mob5824m-wq/OpenTag/docs/app-ui-preview.png

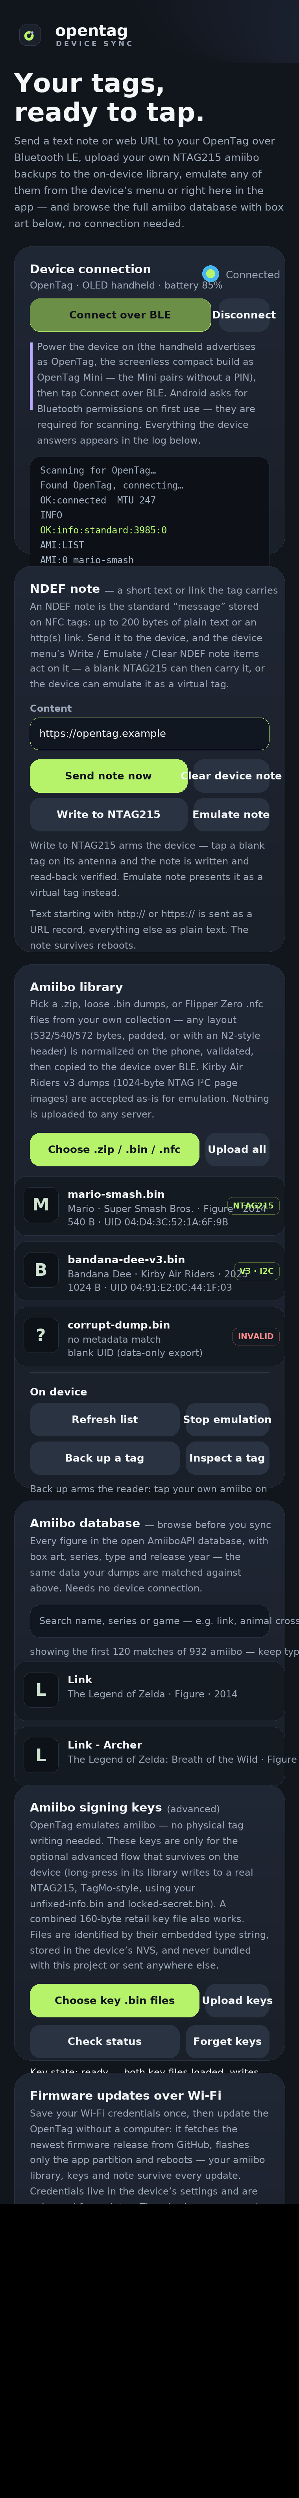
docs/app-ui-preview.png
