mob5824m-wq/OpenTag/docs/stand-engravings.png

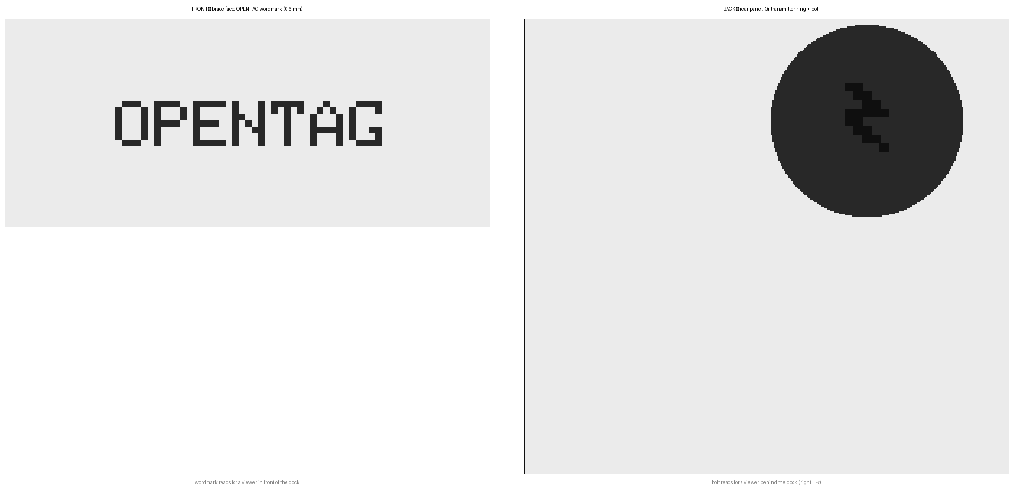
docs/stand-engravings.png
