mob5824m-wq/OpenTag/docs/BOM.md

# OpenTag parts list (BOM)

## Core electronics

| # | Part | Qty | Notes |
|---|---|----|---|
| 1 | ESP32-S3-DevKitC-1 (N8R2 or N16R8, 16 MB flash recommended) | 1 | The 16 MB layout assumed by `partitions_16mb.csv`; an 8 MB board works after switching to a smaller partition table |
| 2 | PN532Killer (NFC-funs, ST25R3916) | 1 | Replaces a PN532 entirely: presents a real 7-byte UID, 8 emulator slots; get the UART-firmware version |
| 3 | SSD1351 1.3" 128×128 OLED module, SPI, 7-pin | 1 | 3.3 V, GH1313-style header |
| 4 | LiPo cell 805040 (3.7 V, ~800 mAh, with protection + JST-PH lead) | 1 | Any 3.7 V cell that fits the shell bay; adjust `bat_*` in the `.cad` |
| 5 | TP4056 USB-C charging module **with protection** (DW01A + 8205A) | 1 | Must be the 6-pad version with B+/B−/OUT+/OUT− |
| 5b | Qi receiver module, 5 V, ⌀ ≤ 40 mm ferrite-backed coil (optional) | 1 | Wireless charging: coil under the battery, see `WIRING.md` |
| 5c | Qi transmitter module, 5 V in / 5 V out, ⌀ ≤ 40 mm coil (optional) | 1 | Turns the printed desk stand into a charger: stick it on the engraved ring + bolt on the stand's rear panel, see `WIRING.md` |
| 6 | MT3608 boost module (adjustable) | 1 | Set to 5.0–5.1 V before installation |
| 7 | 1N5819 Schottky diode (DO-41) | 2 | One on the boost output; the second (optional) ORs the Qi receiver into the TP4056 input |
| 7b | Resistor 22 kΩ (optional) | 1 | Charge-sense wire: TP4056 /CHRG → GPIO21, lights the on-screen bolt |
| 7c | Resistor 100 kΩ (optional) | 2 | Battery divider: B+ ─ 100k ─┬─ 100k ─ GND, midpoint → GPIO4 (header % gauge + low-battery auto-off) |
| 7d | Passive piezo buzzer, 3–5 V, ~12 mm (optional) | 1 | GPIO5 → buzzer → GND; chirps on backup, verified writes, pairing, low battery |
| 8 | SPDT mini toggle switch, PCB mount, ≥1 A (MTS-102 style, 3 pins @ 2.54 mm) | 1 | Master battery cut. The firmware's "hold OK" soft-off is deep sleep, not a disconnect — the DevKitC's regulator and the boost still draw a few mA, so flip this switch for storage |

## PCB & wiring

| # | Part | Qty | Notes |
|---|---|----|---|
| 9 | OpenTag carrier PCB | 1 | `../hardware/pcb/opentag-carrier.kicad_pcb`, 90 × 60 mm, 2 layers, 1.6 mm, HASL/ENIG |
| 10 | Female header 1×22, 2.54 mm | 2 | DevKit socket |
| 11 | Female header 1×7, 2.54 mm | 1 | OLED socket |
| 12 | Male header 1×4, 2.54 mm | 3 | Killer, TP4056, MT3608 |
| 13 | Tactile switch 6×6 mm, through-hole, ~8.5 mm seated height | 4 | Standard 6.5 × 4.5 mm pin pattern; UP / DOWN / OK / BACK |
| 14 | JST-PH-2 through-hole connector | 1 | Battery input |
| 15 | M3 screws + standoffs/nuts | 4 + 4 + 4 | PCB mount (6 mm) and shell closure (12 mm countersunk) |
| 16 | Dupont jumper wires, F–F, ~10 cm | 4 | ESP32 ⇄ PN532Killer (3V3, GND, TX, RX) |
| 17 | Hook-up wire 22–24 AWG | ~8 | TP4056/MT3608 to their headers |
| 18 | Double-sided foam tape / zip ties | — | Securing modules in the shell tray |

## Printed parts (`../hardware/cad/opentag_shell.cad`)

Print-ready STLs are in `hardware/cad/stl/` (front shell, back plate, button
cap — print 4 caps — and the optional desk stand). Regenerate them with OpenSCAD
(`openscad -o front.stl -D 'part="front"' opentag_shell.cad`, etc.) or with
`python3 tools/cad_to_stl.py`, which also self-checks the mesh.

The shell is a slim two-part clamshell (97.6 × 135.6 × 29.3 mm outside,
1.8 mm walls): rectangular OLED window with a chamfered bezel, four button
holes with captive caps, a **fully open** NFC tap window in the back plate
(no plastic over the Killer's antenna) ringed by an outside cradle that
centres a controller or phone, a service window over the DevKitC's BOOT/RST
pads, and a vented power-module tray. Branding is printed in, not added
later: an engraved `OPENTAG` wordmark on the front chin (below the buttons,
using the same pixel font as the OLED and the PCB silkscreen) and an
engraved halo ring around the NFC cradle marking the tap zone — both
0.4–0.6 mm deep, so they survive handling and need no supports.
The back plate's east side carries the **wireless-charge zone**: an engraved
locator ring + bolt marks where the (optional) Qi receiver coil sits — flat
on the plate, under the battery, deliberately on the far side of the bay
from the Killer's antenna. The west wall carries the **charging port**: a slot over the tray's west
end (the tray wall is notched behind it) so the TP4056's USB-C jack and
charge LEDs are reachable with the case closed, marked by an engraved
lightning bolt above the slot — charge the device on that side. Just south
of the slot, a ⌀2.5 mm **light-pipe bore** through the west wall lines up
with a ⌀2.6 mm seat in the tray wall: press a ~5 mm stub of 2.5 mm acrylic
rod through it and the charge LED's glow reaches the outside face. The
south-west corner carries a **lanyard / keyring loop**: a tab shared by both
halves with a continuous 4.2 mm bore through the seam.
Cutouts are placed so nothing needs
supports: both halves print as drawn (front face-down, plate flat-side-down).

| # | Part | Qty | Material |
|---|---|----|---|
| 19 | Front shell | 1 | PLA/PETG — **not** carbon- or metal-filled near the tap zone |
| 20 | Back plate | 1 | PLA/PETG |
| 21 | Button cap | 4 | PLA/PETG or TPU |
| 22 | Desk stand (optional) | 1 | PLA/PETG; device leans ~10° chin-down, charges while docked |
| 23 | Acrylic rod ⌀2.5 mm (optional light pipe) | ~5 mm | Sand/polish the ends; nudge `lp_y` in the `.cad` onto your module's LED |

## OpenTag Mini delta

The screenless variant ([`../hardware/cad/opentag_mini_shell.cad`](../hardware/cad/opentag_mini_shell.cad))
uses the **same** DevKitC-1, PN532Killer, TP4056, MT3608, LiPo, switch,
diodes, sense resistors and piezo as the handheld (items 1, 2, 4–8, 7b–7d
above, unchanged). Changes:

| # | Part | Qty | Notes |
|---|---|----|---|
| — | ~~SSD1351 OLED module (item 3)~~ | 0 | The Mini has no screen — the app/web page is the UI |
| — | ~~Carrier PCB + DevKit/OLED sockets (items 9–11)~~ | 0 | Modules mount in printed trays, point-to-point wiring (`WIRING.md`) |
| 13m | Tactile switch 6×6 mm, ~8.5 mm seated height | **1** | The single OK button, foam-taped to its pedestal (GPIO1) |
| 4m | LiPo cell 40 × 30 × 8 mm (~500 mAh class, protected, JST-PH) | 1 | Sits on the DevKitC; adjust `bat_*` in the mini `.cad` for other sizes |
| 18m | **Closed-cell foam pad, 2 mm, ~40 × 30 mm** | 1 | Double-sided, on the cell's underside — the battery sandwich's spring |
| 19m | Mini front shell | 1 | `hardware/cad/stl/opentag_mini_front_shell.stl` |
| 20m | Mini back plate | 1 | `hardware/cad/stl/opentag_mini_back_plate.stl` |
| 21m | Mini button cap | **1** | `hardware/cad/stl/opentag_mini_button_cap.stl` |
| — | ~~Qi receiver / transmitter (items 5b, 5c)~~ | 0 | No Qi on the Mini — the coil would cover the tap window |

Shell closure uses the same four M3 screws as item 15 (no PCB standoffs).
Regenerate the STLs with `python3 tools/cad_mini_to_stl.py` (self-checking).

**Mini budget:** the handheld total minus OLED (~$10) and PCB/sockets
(~$10) ≈ **$52–82**, filament unchanged.

## Where to buy (no affiliation)

- PN532Killer: pn532killer.com or the NFC-funs store on AliExpress/Taobao
- Everything else: any electronics distributor (Adafruit/SparkFun stock the
  DevKitC-1 and OLED; modules are ubiquitous on Amazon/AliExpress)

## Budget estimate

| Block | Cost (USD, approx.) |
|---|---|
| DevKitC-1 + OLED | $18–25 |
| PN532Killer | $30–40 |
| Battery + TP4056 + MT3608 + switch + diode | $10–14 |
| PCB (5 pcs from JLCPCB/PCBWay) | $5–10 |
| Headers, connectors, hardware | $6–8 |
| Filament | $3–5 |
| Qi receiver + diode + resistor (optional) | $3–6 |
| **Total** | **≈ $72–102** |
