mob5824m-wq/OpenTag/hardware/cad/stl/opentag_mini_front_shell.stl

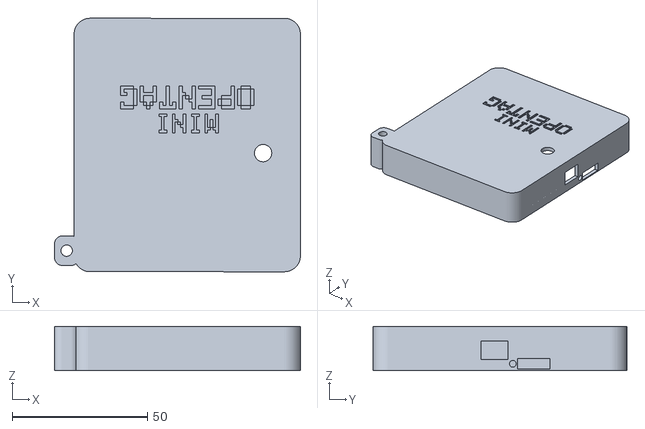
[picture p3: CAD file, 2026-10-30]
hardware/cad/stl/opentag_mini_front_shell.stl
90.8 x 93.6 x 16.3
