mob5824m-wq/OpenTag/hardware/cad/stl/opentag_mini_back_plate.stl

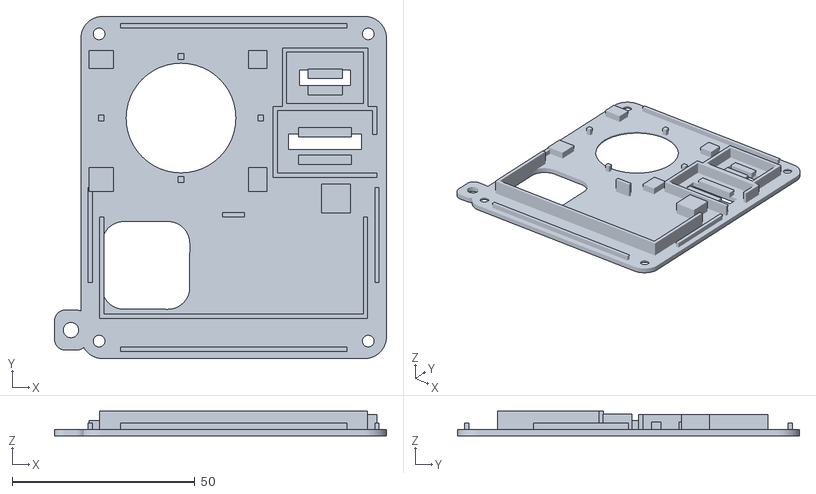
[picture p4: CAD file, 2026-10-30]
hardware/cad/stl/opentag_mini_back_plate.stl
90.8 x 93.6 x 6.80
