mob5824m-wq/OpenTag/hardware/cad/stl/opentag_front_shell.stl

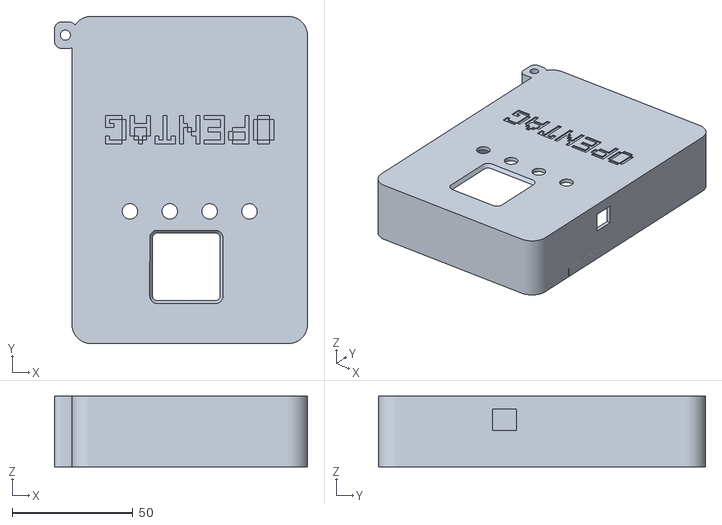
[picture p5: CAD file, 2026-10-30]
hardware/cad/stl/opentag_front_shell.stl
104.8 x 135.6 x 29.3
