mob5824m-wq/OpenTag/hardware/cad/stl/opentag_back_plate.stl

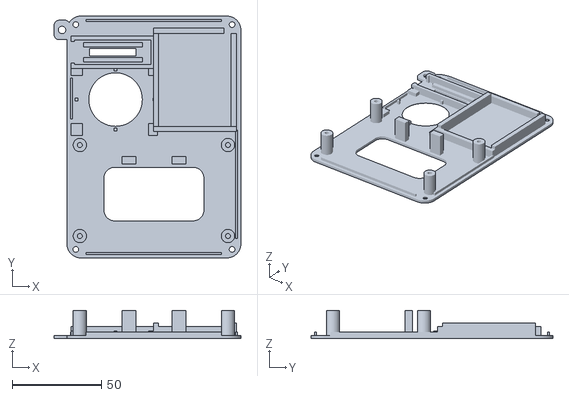
[picture p6: CAD file, 2026-10-30]
hardware/cad/stl/opentag_back_plate.stl
104.8 x 135.6 x 15.8
