mob5824m-wq/OpenTag/hardware/cad/stl/opentag_mini_button_cap.stl

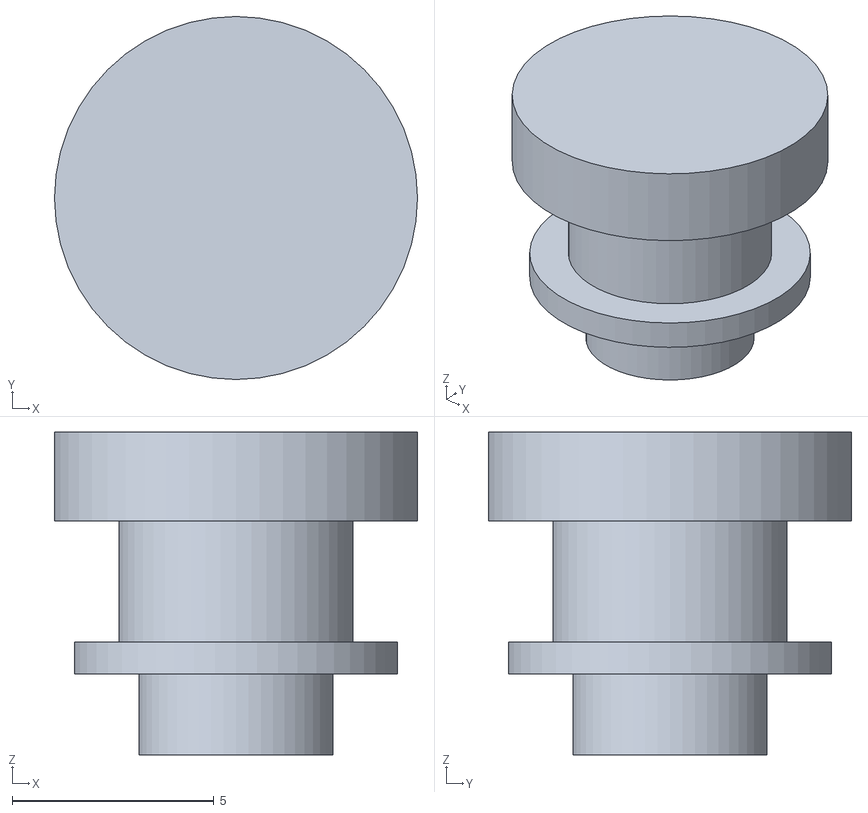
[picture p7: CAD file, 2026-10-30]
hardware/cad/stl/opentag_mini_button_cap.stl
9.00 x 9.00 x 8.00
