mob5824m-wq/OpenTag/hardware/cad/stl/opentag_desk_stand.stl

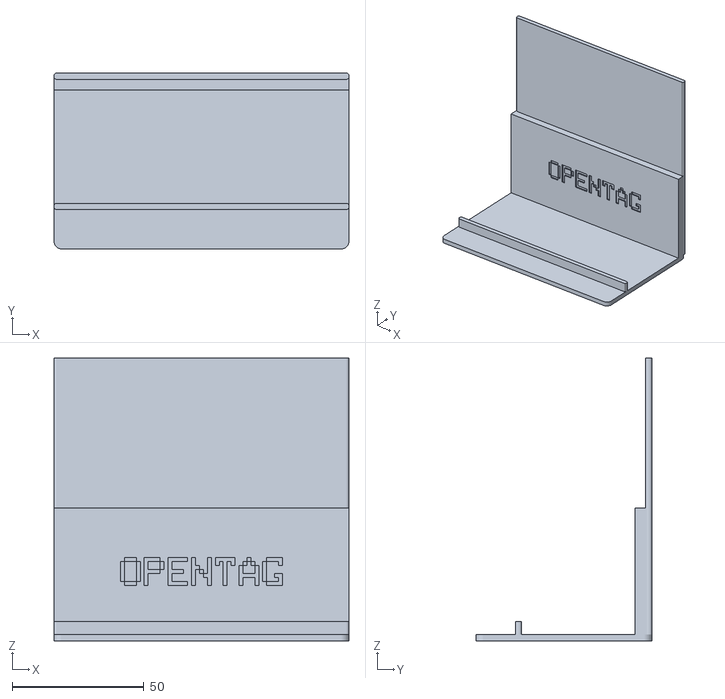
[picture p8: CAD file, 2026-10-30]
hardware/cad/stl/opentag_desk_stand.stl
112.0 x 66.8 x 107.4
