mob5824m-wq/OpenTag/hardware/pcb/opentag-carrier.kicad_pcb

## KiCad design hardware/pcb/opentag-carrier.kicad_pcb (2026-10-30)

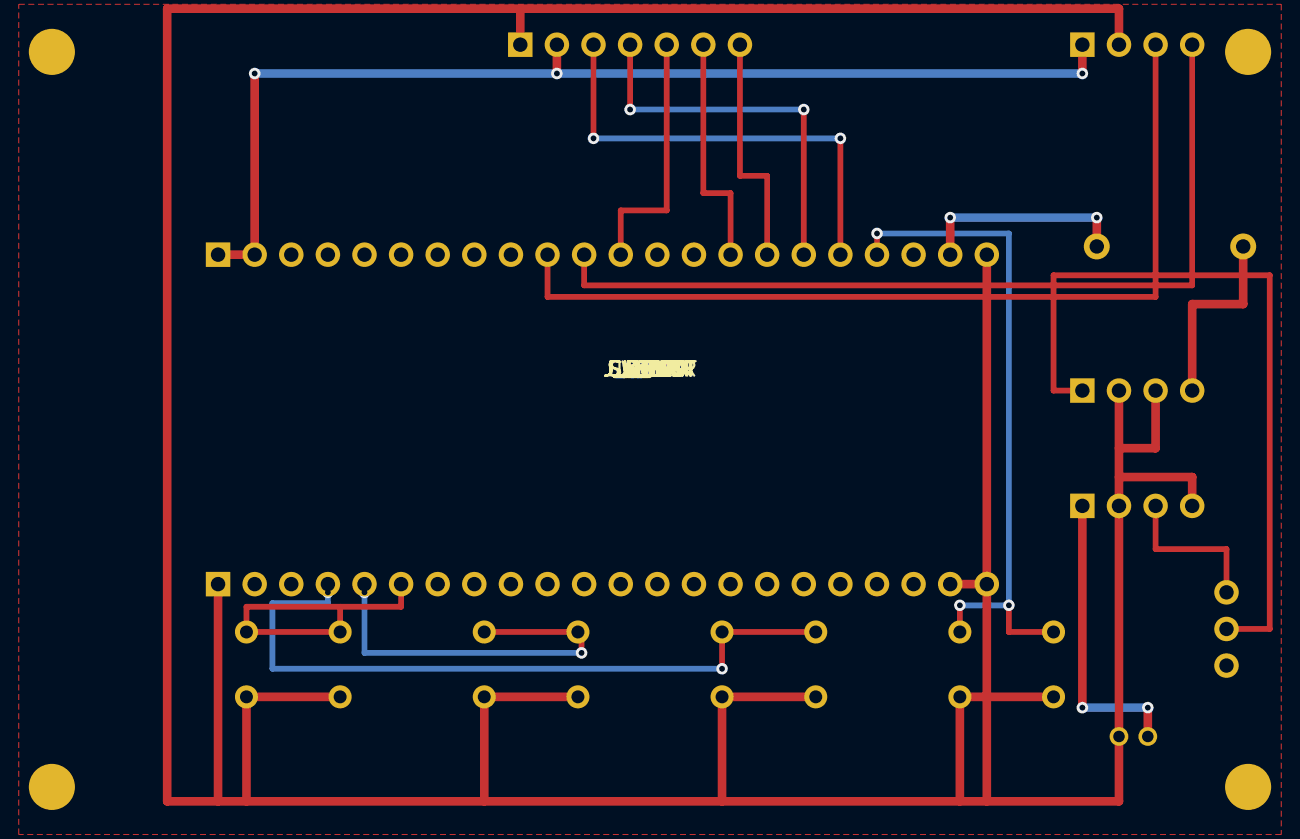
[picture p11: board opentag-carrier.kicad_pcb from above]

Board: 2 copper layers, 10 parts (0 on the bottom side), 18 nets.

Parts:
D1: 1N5819; D_DO-41_10mm
J_BAT: LiPo 3.7V; JST_PH_2
J_BOOST: MT3608 IN+ IN- OUT- OUT+; PinHeader_1x04
J_CHG: TP4056 B+ B- OUT+ OUT-; PinHeader_1x04
J_DEVKIT: ESP32-S3-DevKitC-1; DevKitC1_socket
J_KILLER: PN532Killer J4; PinHeader_1x04
J_OLED: SSD1351 OLED; PinHeader_1x07
MH: MH; Misc
SW_BTN: SW_BTN; Misc
SW_PWR: POWER; Switch_SPDT_row

Connections:
+3V3: J_DEVKIT.J1-1, J_DEVKIT.J1-2, J_KILLER.1, J_OLED.2
+5V: D1.K, J_DEVKIT.J1-21
BOOST5: D1.A, J_BOOST.4
BTN_BACK: J_DEVKIT.J1-19, SW_BTN.25_1, SW_BTN.25_2
BTN_DOWN: J_DEVKIT.J3-5, SW_BTN.-8_1, SW_BTN.-8_2
BTN_OK: J_DEVKIT.J3-4, SW_BTN.8_1, SW_BTN.8_2
BTN_UP: J_DEVKIT.J3-6, SW_BTN.-25_1, SW_BTN.-25_2
ESP_RX: J_DEVKIT.J1-11, J_KILLER.4
ESP_TX: J_DEVKIT.J1-10, J_KILLER.3
GND: J_BAT.2, J_BOOST.2, J_BOOST.3, J_CHG.2, J_CHG.4, J_DEVKIT.J1-22, J_DEVKIT.J3-1, J_DEVKIT.J3-21, J_DEVKIT.J3-22, J_KILLER.2, J_OLED.1, SW_BTN.8_3, SW_BTN.8_4, SW_BTN.25_3, SW_BTN.25_4, SW_BTN.-8_3, SW_BTN.-8_4, SW_BTN.-25_3, SW_BTN.-25_4
OLED_CS: J_DEVKIT.J1-16, J_OLED.7
OLED_DC: J_DEVKIT.J1-15, J_OLED.6
OLED_MOSI: J_DEVKIT.J1-17, J_OLED.4
OLED_RST: J_DEVKIT.J1-12, J_OLED.5
OLED_SCK: J_DEVKIT.J1-18, J_OLED.3
SW1: J_CHG.3, SW_PWR.1
SW2: J_BOOST.1, SW_PWR.2
VBAT: J_BAT.1, J_CHG.1
