mob5824m-wq/OpenTag/(commit log)

2026-10-28 Add standalone ESP32-S3 NFC device prototype
    [partitions_16mb.csv]
2026-10-28 Amiibo emulation via PN532Killer, carrier PCB, handheld shell, LiPo power
    Firmware:
    - pn532_uart.h: PN532/PN532Killer HSU UART driver (ACK/response framing,
    passive polling, InDataExchange, NTAG page R/W, Killer vendor commands:
    SetWorkMode/WriteEmulator/ReadEmulator, full 540-byte image upload)
    - ntag215_emu.h: refactored into page-image builder + dump validator
    (532/540/572-byte containers, BCC0/CC checks, 7-byte UID split pages)
    - main.cpp: rewritten for the new architecture - 5-item menu with amiibo
    library browser, LittleFS store (/amiibo), BLE AMI: protocol (PUT/LIST/
    DEL/EMU/ABORT/STOP/STAT) + new DATA characteristic with sequenced,
    ack-paced chunks; note emulation reuses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
    [opentag-carrier.kicad_pcb, opentag_shell.scad, partitions_16mb.csv]
2026-10-28 Accept every legal rip format in the web-sync dump intake
    The page no longer expects a single exact 532/540/572-byte .bin shape:
    - Flipper Zero .nfc text dumps (Page N: lists) parse loose and inside zips
    - .bin/.tag/.dump/.dat accepted loose; zips also sniff extension-less
    entries by content (strict BCC + CC + vendor checks make false positives
    effectively impossible) and skip non-dumps silently
    - Container tolerance: zero- or newline-padded exports, N2 Elite 572-byte
    files whether the 32-byte header leads or trails, 532-byte no-PWD exports
    (re-padded to 540)
    - Everything is normalized client-side to the full 540-byte page image and
    uploaded as such; the device-side binary contrac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
2026-10-28 Add TagMo-style key files and amiibo write-to-tag
    - device/src/amiibo_crypto.h: portable re-implementation of the amiitool
    (MIT) signing pipeline — key-file parsing by type string, layout
    conversion, DRBG keygen, AES-128-CTR cipher, dual-HMAC unpack/pack and a
    resign() that patches a live tag's UID the way TagMo's writeToTagAuto
    does (including PWD/PACK derivation). Crypto primitives are injected, so
    the module is host-testable.
    - device/test/test_amiibo_crypto.cpp: 62 checks. Reference AES/SHA/HMAC
    backends (verified against FIPS-197/180-4 and RFC 4231) plus golden
    fixtures generated by the real amiitool with random keys — unpack, pack
    and resign are byte-exact against i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
    [Arduino.h, LittleFS.h, NimBLEDevice.h, Preferences.h, amiibo_crypto.h, main.cpp]
2026-10-28 Android app, firmware updater, amiibo metadata, web UI preview
    - android-app/: native Kotlin app (platform APIs only, zero dependencies,
    minSdk 23) for BLE file dumping: scan/connect on the OpenTag service UUID,
    pick .bin dumps or a .zip of them, chunked AMI:PUT upload, on-device
    library list with remote emulate/delete, NDEF note sending, live status
    log. Box art + metadata per bin, matched by file name.
    - amiibo.json (repo root): canonical 932-entry amiibo metadata database
    [name, series, type, game, year] generated from the community AmiiboAPI
    database; tools/gen_amiibo_db.py propagates it to
    device/web-sync/amiibo-db.js and the Android assets. The amiibo ID inside
    retail d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
2026-10-28 Web preview: render text with the exact device font (fixes blur)
    The preview drew text with the browser's anti-aliased font on the 128x128
    canvas and upscaled it 3x, which looked blurry. Replace it with the classic
    5x7 ASCII bitmap font from Adafruit-GFX glcdfont.c - the exact font the
    firmware renders on the SSD1351 - drawn pixel by pixel, and bump the display
    to 4x. Each glyph byte was verified against the C source (475/475 bytes).
2026-10-28 CAD: print-ready STLs; fix shell/back-plate collisions found while exporting
    Adds hardware/cad/stl/{front_shell,back_plate,button_cap}.stl (binary,
    mm) and tools/cad_to_stl.py, a trimesh/manifold3d exporter that parses
    its parameters straight out of opentag_shell.cad and self-checks each
    part (watertight, single body, bbox/volume, ray + signed-distance
    feature probes) plus a closed-position front/back interference test.
    Building the solids exposed real assembly bugs in the .cad, now fixed:
    - mating lip was inner_w+2.4 wide vs the 94 mm cavity mouth (1.2 mm/side
    interference, halves could not close) and crossed bay furniture ->
    four lip segments at 0.2 mm clearance in verified-clear wind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
    [opentag_back_plate.stl, opentag_button_cap.stl, opentag_front_shell.stl]
2026-10-28 Add BACK button (GPIO13) end-to-end; fix preview hover bug; self-explanatory UIs
    Hardware: 4th tactile (BACK) on J1-19/GPIO13 — the repurposed SPI MISO pin,
    since the OLED bus is write-only. Carrier PCB regenerates with a centred
    4-button row (16.5 mm pitch): UP stays on F.Cu, DOWN/OK hop to B.Cu on
    stacked lanes, BACK crosses the socket's east end on B.Cu; self-checks pass
    (90 pads, 89 tracks, 18 vias). Shell CAD + STLs: four button holes, cap
    print count 4. Docs updated (WIRING, BOM, HARDWARE, README).
    Firmware: btnBack handled in every UI state — cancels tag-scan/write, stops
    emulation, skips lock confirm, and gives the populated amiibo library its
    first exit path back to the menu. S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
    [opentag-carrier.kicad_pcb, opentag_front_shell.stl]
2026-10-28 Shell rework: rect OLED window, slimmer walls, open NFC tap zone, cutouts; PCB Gerbers
    Hardware shell (opentag_shell.cad + tools/cad_to_stl.py):
    - Rectangular OLED window (28x28, r2) with a 1.2 mm outward chamfer,
    replacing the circular d30 window
    - Slimmer shell: 1.8 mm walls/floor (was 2.4/2.0), inner depth 27.5
    (was 30.6) -> front 44.6 cm3 (was 63.5), back 27.5 (was 34.3)
    - Fully OPEN NFC tap window (d30 through-cut) over the PN532Killer
    antenna with a d40 x 1.2 mm outside cradle that centres a controller
    or phone on it - zero plastic over the antenna for best range
    - Cutouts/supports: service window (56x30) over the DevKitC BOOT/RST
    pads, tray vent between the tie-down bars, tw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
    [opentag-B_Cu.gbr, opentag-B_Mask.gbr, opentag-B_SilkS.gbr, opentag-Edge_Cuts.gbr, opentag-F_Cu.gbr, opentag-F_Mask.gbr, opentag-F_SilkS.gbr, opentag.drl]
2026-10-29 Docs: step-by-step setup paths (preview/bench/full build); serve hint on sync page
    - README: new 'Set up your OpenTag' section with three on-ramps:
    A) web preview with no hardware, B) bench build (parts list, PlatformIO
    flash commands, wiring table with DevKit pin numbers/GPIOs, BLE pairing
    steps incl. the localhost serve command), C) full handheld (gerbers zip,
    STLs, WIRING/BOM pointers). Build commands moved out of the old
    'Build and flash' section, which is now 'Tests and gates'.
    - web-sync connect card: state the browser + secure-origin requirement up
    front with the exact 'python3 -m http.server 8000' command, instead of
    only surfacing it as an error after a failed connect.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
2026-10-29 Menu: Amiibo library first (emulation is the main use)
    The device now boots with the amiibo library highlighted instead of the
    NDEF note writer: Amiibo library -> BLE sync -> Write NDEF note ->
    Emulate NDEF note -> Clear NDEF note. Mirrored in the web preview;
    README device-menu section updated. Actions and BLE commands unchanged -
    only the menu order and default cursor moved.
2026-10-29 Branding in CAD + long-press OK soft power
    CAD: engraved OPENTAG wordmark on the front chin (same 5x7 pixel font
    as the OLED/preview/silk, extracted from the repo font table, rotated
    to read OLED-up) and an engraved halo ring around the back-plate NFC
    cradle as the tap-zone locator. Pixels inflate 0.02 mm so diagonal
    glyph contacts overlap instead of pinching the surface non-manifold.
    Exporter mirrors both cuts, re-pins volumes (front 44421, back 27430)
    and probes engrave depth, halo groove and surrounding material.
    Firmware: hold OK 1 s at the menu -> Powering off screen (BACK cancels
    within 700 ms) -> OLED parked + deep sleep; hold OK 1 s to wake (early
    release goes back to sleep, screen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
    [opentag_back_plate.stl, opentag_front_shell.stl]
2026-10-29 feat: v3 (Air Riders, NTAG I2C Plus 2K) amiibo emulation + library name polish
    Firmware: verbatim 1024-byte dumps accepted, killerLoadNtagImageV3 onto
    slot 0 (fail -> 'Killer fw lacks V3'), physical writes refused with
    'V3: emulation only', V3 badge in the library, EMULATE screen states
    'V3 tag on slot 0'. Web-sync intake detects v3 before parsing and
    renders Flipper .nfc to 255 pages. Web preview mirrors all of it plus
    console/phone read feedback. Library names: extension stripped, words
    capitalized, on both device and preview. DB regenerated with the two
    public Air Riders figure IDs.
    [LittleFS.h, main.cpp, ntag215_emu.h, pn532_uart.h, test_ntag215_emu.cpp, test_pn532_uart.cpp]
2026-10-29 fix: 8-byte idPages buffer in crypto round-trip test read 1 byte OOB
    resign() takes 9 idPages bytes (8 UID/BCC + live page-2 byte 0); the
    restore-to-original call passed an 8-byte local, so idPages[8] read
    uninitialized stack. Passed at -O0 by luck, failed at -O2. Copy 9 bytes
    from REF_TAG; 62/62 at both -O0 and -O2.
    [test_amiibo_crypto.cpp]
2026-10-29 feat: charging port with engraved bolt indicator + printed user guide
    The TP4056's USB-C had no case opening - charging was impossible with
    the shell closed. West wall now has a 12x4 mm charge-port slot over the
    power tray (tray west wall notched behind it so the jack and charge
    LEDs reach the slot), marked by an engraved 6x8 px lightning bolt on
    the outer face above it. Seat the TP4056 USB-C-west per WIRING.md.
    Also adds docs/opentag-user-guide.pdf, a 10-page A5 instruction booklet
    (charging, buttons, library, V3, physical writes, NDEF, sync, updates,
    troubleshooting, care) generated by tools/make_booklet.py, which parses
    the wordmark font and bolt icon straight from the .cad so the artwor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
    [opentag_back_plate.stl, opentag_front_shell.stl]
2026-10-29 feat: hot-swap amiibo across all 8 PN532Killer emulator slots
    While an amiibo is emulating, UP/DOWN now swaps to the neighbouring
    library entry without stopping: each swap loads the dump onto the next
    of the Killer's eight slots (rotating, so the slot being presented is
    never rewritten mid-poll) and re-enters emulator mode on it. OK/BACK
    stop as before; NDEF-note emulation keeps any-button-stops. The EMULATE
    screen shows the live slot ('Killer slot 3 active' / 'V3 tag on slot
    3') and a swap hint; swaps emit OK:emulating:<name> over BLE, and a v3
    swap on old Killer firmware reports 'Killer fw lacks V3' without
    stopping the current emulation. Web preview mirrors the whole flow;
    library_smoke c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
    [main.cpp, make_booklet.py]
2026-10-29 feat: auto-sleep, per-amiibo random-UID re-sign, lanyard loop
    Auto-sleep: after 3 minutes with no button, BLE or tag activity the
    device powers off through the soft-power flow (BACK still cancels in
    the window, hold OK wakes). Idle timer resets on raw button levels,
    BLE command/data writes and tag arrival, so transfers never die
    mid-flight.
    Random-UID re-sign: hold DOWN on a library entry to flag it for UID
    randomization ('R' badge; zero-byte .rnd sidecar persists it). Each
    emulation or hot-swap of a flagged v2 entry re-signs the dump with a
    fresh random UID + BCCs via the existing amiitool crypto (page-2 byte
    0 preserved, UID pages patched for the virtual tag) - consoles treat
    it as a new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
    [opentag_back_plate.stl, opentag_front_shell.stl]
2026-10-29 feat: tag backup, travel mode, factory reset, desk stand, light pipe
    - Backup tag (reader mode): read + validate a presented NTAG215 (or V3)
    and save it to the library under the tag's UID; identical re-reads say
    'Already saved', rewritten tags get -2/-3 suffixes
    - Travel mode: hold BACK at the menu toggles BLE advertising off
    (persisted in NVS, survives updates); BLE sync reports 'Travel: BLE off'
    - Factory reset: last menu item, OK-hold 1.2 s to confirm, any short
    press or 15 s cancels; wipes library, keys and settings
    - Buttons: UP/DOWN hold-to-auto-repeat (450/280/180/110 ms ramp); the
    random-UID flag moves to BACK-hold (BACK short exits the library)
    - CAD: charge-status light p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
    [opentag_back_plate.stl, opentag_desk_stand.stl, opentag_front_shell.stl]
2026-10-29 feat: optional Qi wireless charging + on-screen charge bolt
    Hardware (no firmware change needed to charge):
    - Qi receiver (5 V, coil <= 40 mm, ferrite-backed) sits on the back plate
    under the battery, on a new engraved locator ring + bolt (halo-style,
    east of the tap halo so the Killer's antenna stays clear); a second
    1N5819 ORs the receiver into the TP4056's input so USB-C and Qi share
    the existing charger, LEDs and light pipe
    - WIRING.md gains the wireless-charging section + CHG_SENSE signal row;
    BOM rows 5b/7b + budget line; HARDWARE.md interface row + power note
    Firmware + web preview (optional charge-sense wire):
    - TP4056 /CHRG via 22k to GPIO21 (J3-18), INPUT_PULLUP so unwir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
    [opentag_back_plate.stl]
2026-10-29 feat: tag inspector, battery gauge, BLE pairing, USB drive, Wi-Fi OTA, piezo + redesigned stand & wiring diagram
    Backlog items 3-7 and 10, each in the established pattern (firmware +
    mirrored web preview + docs + gates):
    - Tag inspector (menu 3): tap any tag to see UID, chip type/size from the
    capability container (NTAG213/215/216, MIFARE UL) and the first bytes of
    any NDEF text/URI record. Never writes; retap rescans.
    - Battery telemetry: optional 100k/100k divider on B+ to GPIO4. Header %
    gauge (red <=15%), one-shot warn at 3.35 V, clean auto power-off below
    3.25 V sustained 30 s, suspended while charging, hidden without divider.
    - BLE pairing: numeric-comparison PIN (random per b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
    [opentag_desk_stand.stl]
2026-10-30 ci: auto-build a signed Android APK release on every merge to main
    New workflow (.github/workflows/android-app.yml):
    - push to main (i.e. every PR merge) -> build the release APK, tag
    app-v<semver> (patch-bumped from the last app tag), create a GitHub
    release with opentag-android-<ver>.apk + .sha256 attached.
    - pull requests touching android-app/** only build, as a compile gate.
    - versionCode = run number (monotonic), versionName = the tag; injected
    via -PappVersionCode/-PappVersionName into app/build.gradle.kts.
    - signing: committed 'open' release key (android-app/keys/) by default so
    releases upgrade over one another; OT_KEYSTORE_B64/OT_KEYSTORE_PASSWORD
    repo secrets override it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
2026-10-30 fix(android): compile errors in the BLE upload path
    - pumpStream used an expression body (= synchronized {...}) whose last
    statement (streamSeq++) made the inferred return type Int, clashing with
    the 'return finishUpload(...)' exits; give it a Unit block body.
    - handleNotify's when was the synchronized lambda's last expression and
    needed an else branch to be exhaustive.
    Caught by the new PR compile gate (annotations from the workflow's
    failure-report step).
2026-10-30 docs: consolidate guides into docs/; engrave branding + Qi mark on the stand
    - move HARDWARE.md, BOM.md, WIRING.md (+ wiring_diagram.png),
    README-ANDROID.md and keys/README.md into docs/ as HARDWARE.md, BOM.md,
    WIRING.md, ANDROID-APP.md, SIGNING-KEY.md; root README.md stays as the
    GitHub landing page; all cross-links updated (README, make_booklet.py,
    build.gradle.kts, android-app.yml)
    - desk stand: engraved OPENTAG wordmark (brand font, 1.5 mm pixels) on the
    brace's front face, and a halo-style ring + bolt on the rear panel's back
    face marking the 5 V Qi-transmitter coil spot (BOM 5c, WIRING.md) so the
    dock charges the docked device; centred under the docked receiver as far
    u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
    [opentag_desk_stand.stl]
2026-10-30 docs: stand-engraving render (wordmark + Qi mark) referenced from WIRING.md
2026-10-30 android: redesign the app UI to replicate the web sync page
    - dark mint/violet theme lifted 1:1 from device/web-sync (colors, cards,
    buttons, inputs, chips, thumbs, log console, status dot with glow,
    radial window glow), brand header + headline + card-per-section layout
    - one scrolling column: Device connection (dot + live state, connect /
    disconnect, notice, log console), NDEF note (send + new Clear device
    note via NOTE:CLEAR), Amiibo library (phone dumps + on-device list with
    empty states), Amiibo database (search over name/series/game with box
    art, first 120 rows, count line), footer
    - intake now matches the web page exactly: 532/540/572-byte containers
    (padded or N2-headere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
2026-10-30 docs: opentag-logo.png — the mark + full-bleed launcher-mask showcase
2026-10-30 OpenTag Mini: screenless, PIN-free variant — firmware, CAD, app/web, docs
    A second device that keeps the same BLE protocol and library but drops
    the screen, nav buttons and pairing PIN, in a 44%-thinner shell:
    Firmware (device/src/mini/main.cpp, env opentag_mini):
    - one button (OK, GPIO1, RTC wake): short = battery chirps, triple =
    travel mode, hold 1.5 s = off; just-works BLE pairing (IOCap 3 + bond)
    - NOTE:WRITE/EMU, AMI:BACKUP/RAND, TAG:INSPECT, INFO, USB drive, Wi-Fi
    OTA — same status contract as the handheld; piezo chirps replace OLED
    - handheld main.cpp: remote-armed flag + OK:inspect/OK:backup emitters,
    INFO model reply, OTA release asset prefix fix
    - CI: firmware.yml build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
    [opentag_mini_back_plate.stl, opentag_mini_button_cap.stl, opentag_mini_front_shell.stl]
2026-11-02 app: fix the amiibo library not scrolling — lists join the page flow
    The three lists (phone dumps, device library, database browser) were
    ListViews in fixed-height boxes nested inside the page's ScrollView.
    Nested scrollables fight over the drag gesture: the inner list and the
    page each try to claim it, so the library often refuses to scroll at
    all. The web page never had this problem — its lists sit in the page
    flow and the page itself scrolls.
    Do the same in the app: the three list containers are now plain
    LinearLayouts in the page flow; renderLocal()/renderDevice()/renderDb()
    rebuild their rows (same item_amiibo rows, same binding, same tap and
    long-press actions, same mint press rip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
